Elektrochecker/SCD30-environment-sensor/pcb/display/display.kicad_pcb

## KiCad design pcb/display/display.kicad_pcb (2025-05-04)

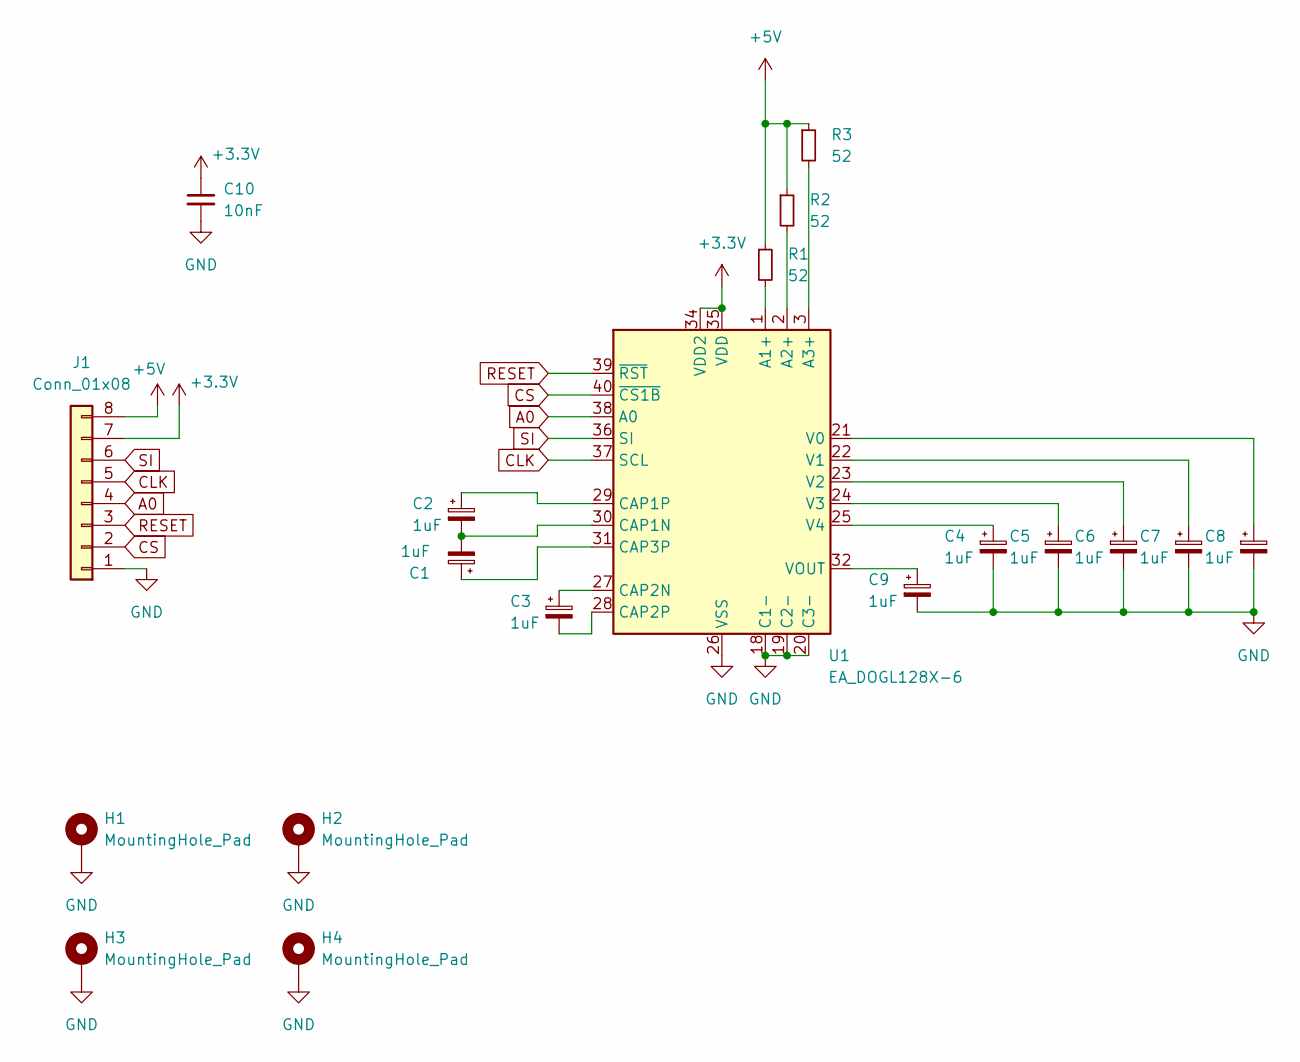
[picture p1: schematic display.kicad_sch]

Parts:
C1, C2, C3, C4, C5, C6, C7, C8, C9: 1uF; CP_Radial_D5.0mm_P2.50mm
C10: 10nF; C_Disc_D3.8mm_W2.6mm_P2.50mm
H1, H2, H3, H4: MountingHole_Pad; MountingHole_3.2mm_M3_DIN965_Pad
J1: Conn_01x08; PinHeader_1x08_P2.54mm_Vertical
R1, R2, R3: 52; R_Axial_DIN0207_L6.3mm_D2.5mm_P10.16mm_Horizontal
U1: EA_DOGL128X-6; EA_DOGL128-6

Connections:
+3.3V: C10.1, J1.7, U1.34 (VDD2), U1.35 (VDD)
+5V: J1.8, R1.1, R2.1, R3.1
A0: J1.4, U1.38 (A0)
CLK: J1.5, U1.37 (SCL)
CS: J1.2, U1.40 (~CS1B)
GND: C4.2, C5.2, C6.2, C7.2, C8.2, C9.2, C10.2, H1.1, H2.1, H3.1, H4.1, J1.1, U1.18 (C1-), U1.19 (C2-), U1.20 (C3-), U1.26 (VSS), U1.33 (VSS)
unnamed: R1.2, U1.1 (A1+)
unnamed: R2.2, U1.2 (A2+)
unnamed: R3.2, U1.3 (A3+)
unnamed: C1.2, C2.2, U1.30 (CAP1N)
unnamed: C2.1, U1.29 (CAP1P)
unnamed: C3.1, U1.27 (CAP2N)
unnamed: C3.2, U1.28 (CAP2P)
unnamed: C1.1, U1.31 (CAP3P)
unnamed: C8.1, U1.21 (V0)
unnamed: C7.1, U1.22 (V1)
unnamed: C6.1, U1.23 (V2)
unnamed: C5.1, U1.24 (V3)
unnamed: C4.1, U1.25 (V4)
unnamed: C9.1, U1.32 (VOUT)
RESET: J1.3, U1.39 (~RST)
SI: J1.6, U1.36 (SI)

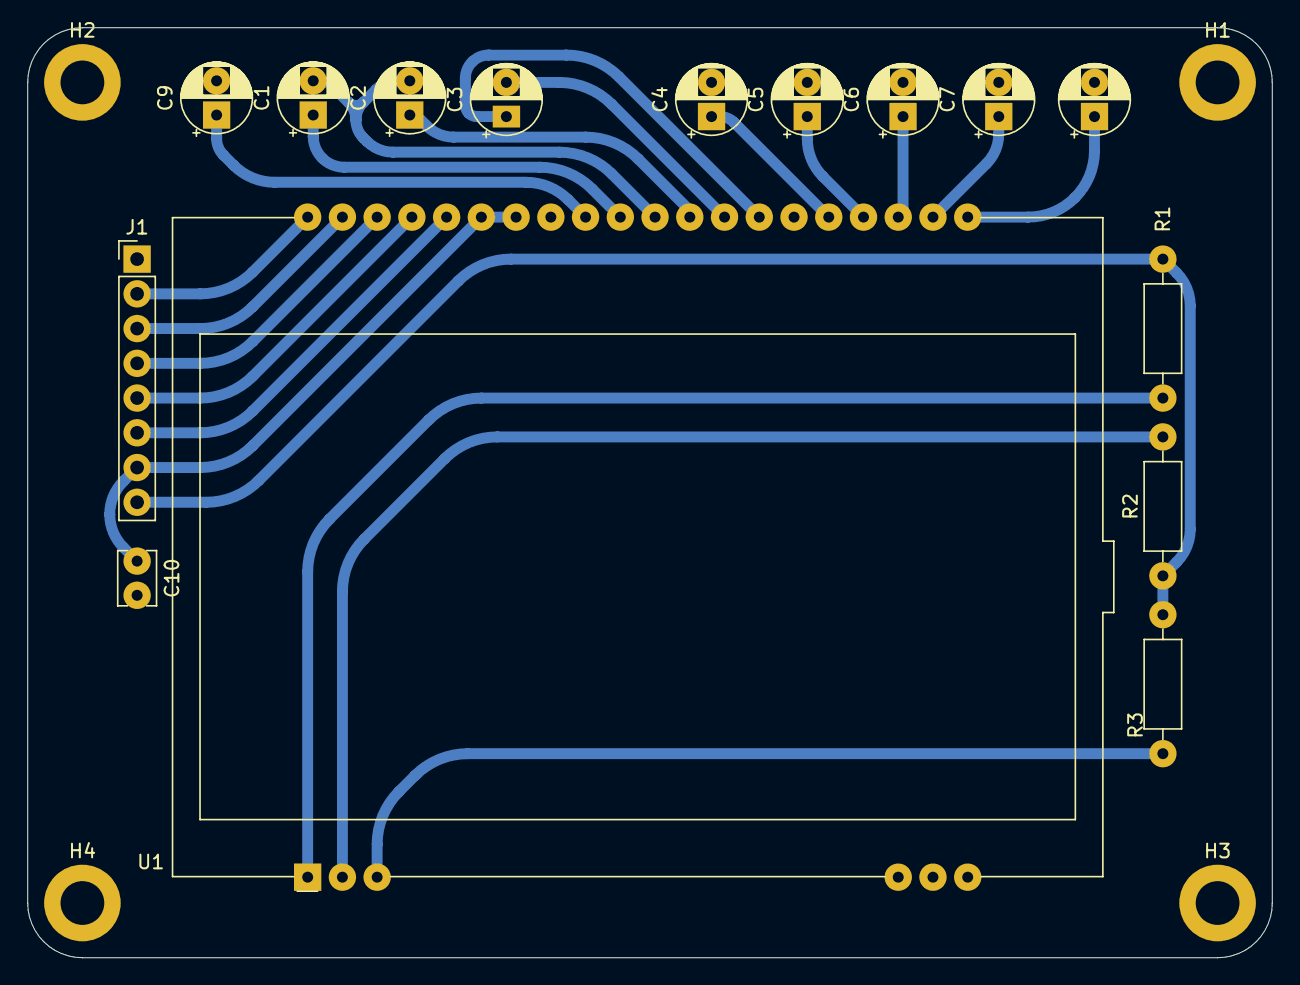
[picture p2: board display.kicad_pcb from above]

Board: 2 copper layers, 91.0 x 68.0 mm, 19 parts (0 on the bottom side), 22 nets.
