Elektrochecker/SCD30-environment-sensor/pcb/scd30-control-board/scd30-control-board.kicad_pcb

## KiCad design pcb/scd30-control-board/scd30-control-board.kicad_pcb (2025-05-01)

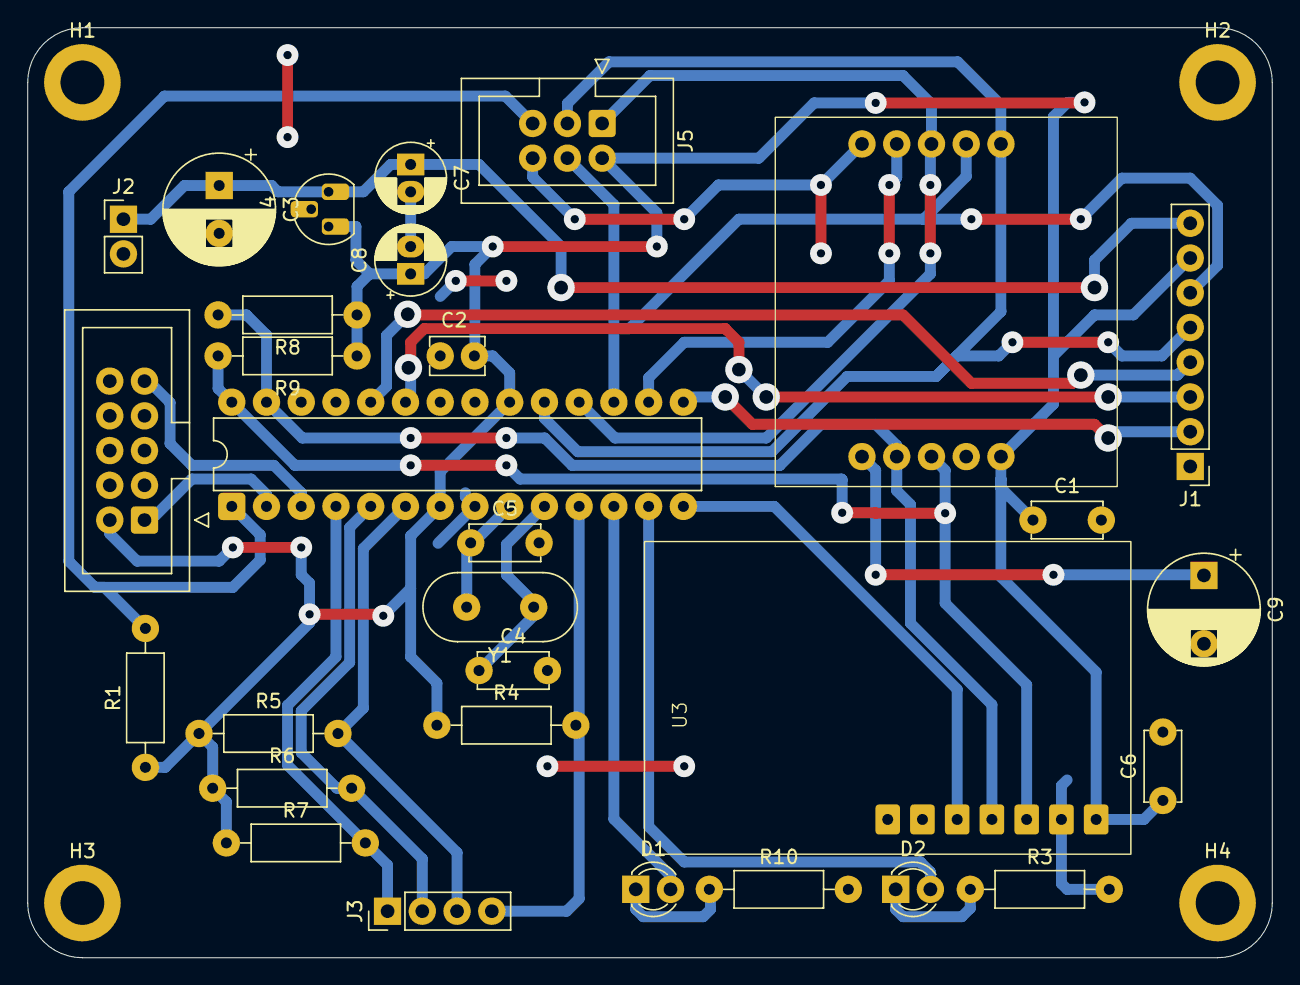
[picture p3: board scd30-control-board.kicad_pcb from above]

Board: 2 copper layers, 91.0 x 68.0 mm, 34 parts (0 on the bottom side), 27 nets.

Parts:
C1, C6: 100nF; C_Disc_D5.0mm_W2.5mm_P5.00mm
C2: 10nF; C_Disc_D3.8mm_W2.6mm_P2.50mm
C3: 330uF; CP_Radial_D8.0mm_P3.50mm
C4, C5: 22pF; C_Disc_D5.0mm_W2.5mm_P5.00mm
C7, C8: 1uF; CP_Radial_D5.0mm_P2.00mm
C9: C_Polarized; CP_Radial_D8.0mm_P5.00mm
D1, D2: LED_Small; LED_D3.0mm
H1, H2, H3, H4: MountingHole_Pad; MountingHole_3.2mm_M3_DIN965_Pad
J1: Conn_01x08; PinHeader_1x08_P2.54mm_Vertical
J2: Conn_01x02; PinHeader_1x02_P2.54mm_Vertical
J3: Conn_01x04; PinHeader_1x04_P2.54mm_Vertical
J4: UART; IDC-Header_2x05_P2.54mm_Vertical
J5: ISP; IDC-Header_2x03_P2.54mm_Vertical
R1, R4, R5, R6, R7: 100k; R_Axial_DIN0207_L6.3mm_D2.5mm_P10.16mm_Horizontal
R3, R8, R9, R10: 1k; R_Axial_DIN0207_L6.3mm_D2.5mm_P10.16mm_Horizontal
U1: clock&memory_module
U2: ATmega328P-P; DIP-28_W7.62mm
U3: SCD30
U4: LP2950-3.3_TO92; TO-92_HandSolder
Y1: Crystal_Small; Crystal_HC18-U_Vertical

Connections:
+3.3V: C1.1, C2.1, C6.1, C8.1, J1.7, J4.2, J5.2, R1.1, R4.1, R5.1, R6.1, R7.1, R8.1, R9.1, U1.5 (3V3), U2.7 (VCC), U2.20 (AVCC), U3.1 (VIN), U4.1 (VO)
+5V: C3.1, C7.1, J1.8, J2.1, U4.3 (VI)
/DISPLAY_A0: J1.4, U2.24 (PC1)
/DISPLAY_RESET: J1.3, U2.23 (PC0)
/I2C_SCL: R9.2, U1.3 (SCL), U2.28 (PC5), U3.3 (SCL)
/I2C_SDA: R8.2, U1.2 (SDA), U2.27 (PC4), U3.4 (SDA)
/RESET: J5.5, R1.2, U2.1 (~RESET/PC6)
/SENSOR_RDY: U2.14 (PB0), U3.5 (RDY)
/SPI_CLK: J1.5, J5.3, U1.6 (CLK), U2.19 (PB5)
/SPI_CS_FLASHMEM: U1.9 (CS), U2.16 (PB2)
/SPI_CS_LCD: J1.2, U2.15 (PB1)
/SPI_MISO: J5.1, U1.8 (MISO), U2.18 (PB4)
/SPI_MOSI: J1.6, J5.4, U1.7 (MOSI), U2.17 (PB3)
/UART_RX: J4.1, U2.2 (PD0)
/UART_TX: J4.9, U2.3 (PD1)
GND: C1.2, C2.2, C3.2, C4.2, C5.2, C6.2, C7.2, C8.2, C9.2, H1.1, H2.1, H3.1, H4.1, J1.1, J2.2, J4.10, J5.6, R3.2, R10.2, U1.10 (GND), U2.8 (GND), U2.22 (GND), U3.2 (GND), U3.7 (SEL), U4.2 (GND)
unnamed: D1.2 (A), U2.12 (PD6)
unnamed: D1.1 (K), R10.1
unnamed: D2.2 (A), U2.13 (PD7)
unnamed: D2.1 (K), R3.1
unnamed: J3.1, R7.2, U2.4 (PD2)
unnamed: J3.2, R6.2, U2.5 (PD3)
unnamed: J3.3, R5.2, U2.6 (PD4)
unnamed: J3.4, R4.2, U2.11 (PD5)
unnamed: C9.1, U1.1 (VBACKUP)
unnamed: C5.1, U2.9 (XTAL1/PB6), Y1.2
unnamed: C4.1, U2.10 (XTAL2/PB7), Y1.1
