Elektrochecker/SCD30-environment-sensor/config.h

#ifndef CONFIG_H
#define CONFIG_H

// ATmega fuses
// lfuse = 0xef ; 16MHz low power external crystal oscillator, no clock divider
// hfuse = 0xd9 ; ATmega default

// mcu clock frequency [Hz]
#define F_CPU 16000000

// compiling with the part flag (-mmcu) set will automatically set
// this macro, so we guard for redefinition
#ifndef __AVR_ATmega328P__
#define __AVR_ATmega328P__
#endif

#endif
