Elektrochecker/SCD30-environment-sensor/display_font.c

#include "display_font.h"

const PROGMEM uint8_t font_standard[96][7] = {
    /* 20   */ {0x00, 0x00, 0x00, 0xaa, 0xaa, 0xaa, 0xaa},
    /* 21 ! */ CHAR_UNDEFINED,
    /* 22 " */ CHAR_UNDEFINED,
    /* 23 # */ CHAR_UNDEFINED,
    /* 24 --*/ {0x08, 0x08, 0x08, 0x08, 0x08, 0xaa, 0xaa}, //  non-ASCII  $ => -- (long hyphen)
    /* 25 % */ {0x46, 0x26, 0x10, 0x08, 0x64, 0x62, 0xaa},
    /* 26 d */ {0x60, 0x58, 0x46, 0x58, 0x60, 0xaa, 0xaa}, //  non-ASCII  & => (delta)
    /* 27 ' */ CHAR_UNDEFINED,
    /* 28 ( */ {0x3E, 0x41, 0xaa, 0xaa, 0xaa, 0xaa, 0xaa},
    /* 29 ) */ {0x41, 0x3E, 0xaa, 0xaa, 0xaa, 0xaa, 0xaa},
    /* 2A * */ CHAR_UNDEFINED,
    /* 2B + */ CHAR_UNDEFINED,
    /* 2C , */ {0x80, 0x60, 0xaa, 0xaa, 0xaa, 0xaa, 0xaa},
    /* 2D - */ {0x10, 0x10, 0x10, 0xaa, 0xaa, 0xaa, 0xaa},
    /* 2E . */ {0x60, 0x60, 0xaa, 0xaa, 0xaa, 0xaa, 0xaa},
    /* 2F / */ CHAR_UNDEFINED,

    /* 30 0 */ {0x3e, 0x41, 0x41, 0x41, 0x3e, 0xaa, 0xaa}, // digits are monospaced
    /* 31 1 */ {0x00, 0x42, 0x7F, 0x40, 0x00, 0xaa, 0xaa},
    /* 32 2 */ {0x71, 0x49, 0x49, 0x49, 0x46, 0xaa, 0xaa},
    /* 33 3 */ {0x41, 0x49, 0x49, 0x49, 0x36, 0xaa, 0xaa},
    /* 34 4 */ {0x1C, 0x12, 0x11, 0x7F, 0x10, 0xaa, 0xaa},
    /* 35 5 */ {0x4F, 0x49, 0x49, 0x49, 0x31, 0xaa, 0xaa},
    /* 36 6 */ {0x3E, 0x49, 0x49, 0x49, 0x30, 0xaa, 0xaa},
    /* 37 7 */ {0x01, 0x71, 0x09, 0x05, 0x03, 0xaa, 0xaa},
    /* 38 8 */ {0x36, 0x49, 0x49, 0x49, 0x36, 0xaa, 0xaa},
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
    /* 7D ö */ {0x39, 0x44, 0x44, 0x44, 0x39, 0xaa, 0xaa}, // non-ASCII  } => ö
    /* 7E ü */ {0x3d, 0x40, 0x40, 0x40, 0x7d, 0xaa, 0xaa}, // non-ASCII  ~ => ü
    /* 7F   */ {0xaa, 0xaa, 0xaa, 0xaa, 0xaa, 0xaa, 0xaa}  // non-ASCII  ? => (empty char) (1 pixel space in text)

};
