Elektrochecker/SCD30-environment-sensor/(commit log)

2025-04-18 add uart println
2025-04-18 sensor data conversion
2025-04-25 add display PCB
    [display.kicad_pcb, display.kicad_sch]
2025-05-01 make main PCB
    [scd30-control-board.kicad_pcb, scd30-control-board.kicad_sch]
2025-05-04 resize display pcb to match main board
    [display.kicad_pcb, display.kicad_sch]
2025-05-07 move twi error messages to flash
    [twi.c, twi.h]
2025-05-16 implement spi display
2025-05-16 show sensor reading on display
2025-05-27 display write text to frame buffer
2025-06-10 save measurements to flash storage, dump flash data to UART
2025-06-10 fix serialization of datetime
    [clock.c, main.c, uart.h]
